EngineeringbyRacingMotorsport/ES_RearECU_HW/ES_RearECU_HW.kicad_pcb

## KiCad design ES_RearECU_HW.kicad_pcb (2026-10-03)

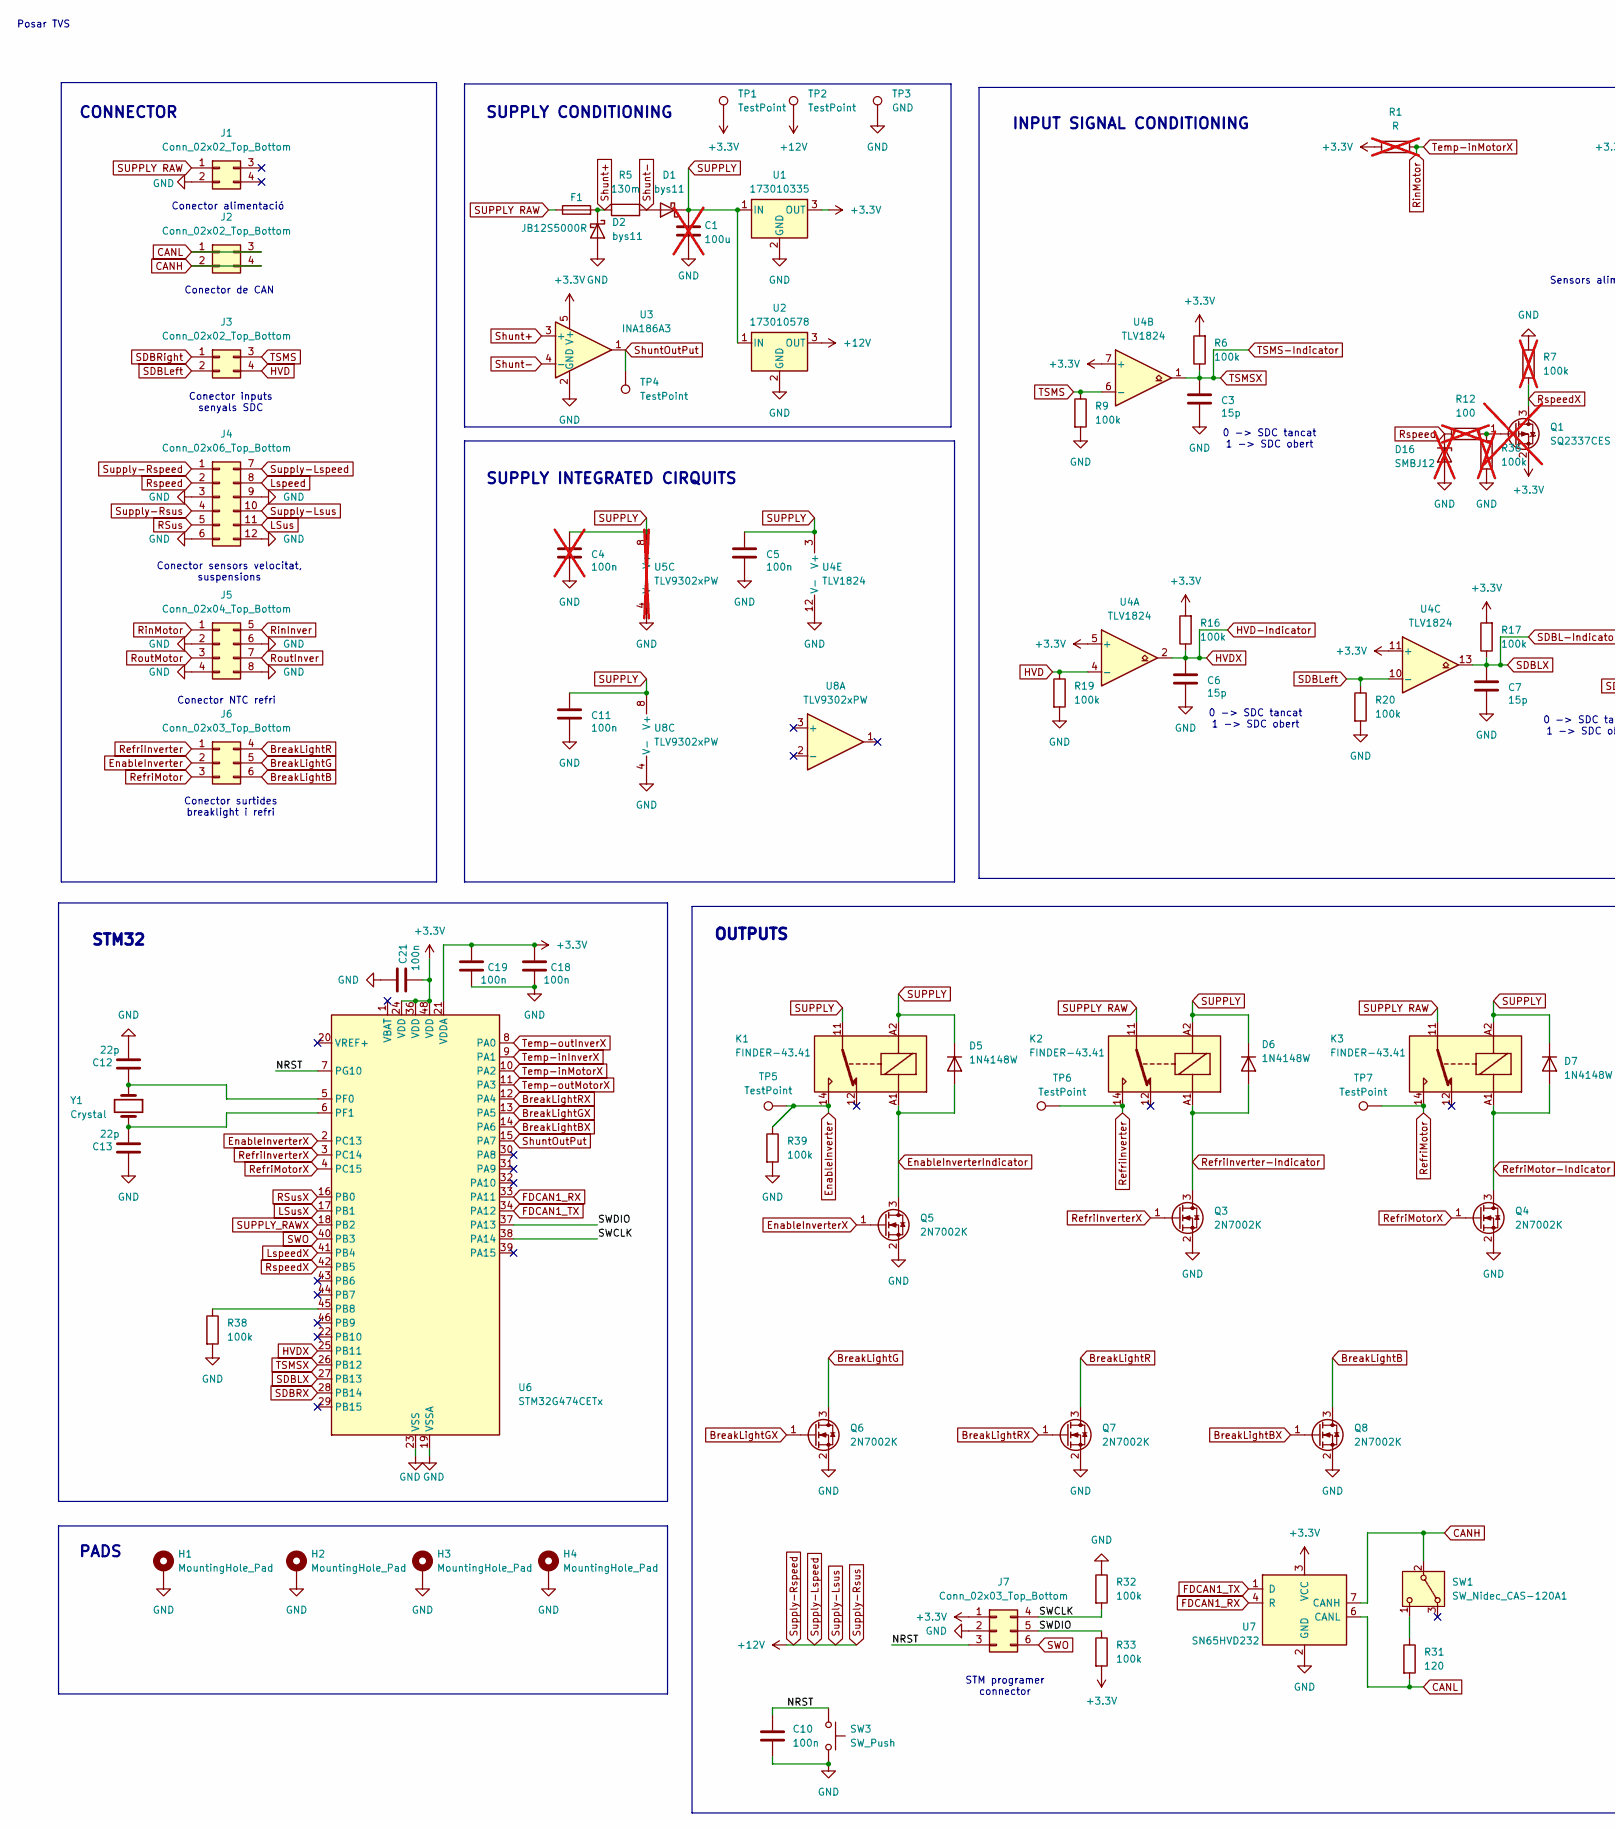
[picture p1: schematic ES_RearECU_HW.kicad_sch, RearEcu_EM-06_1.0, part in row 1, column 1]

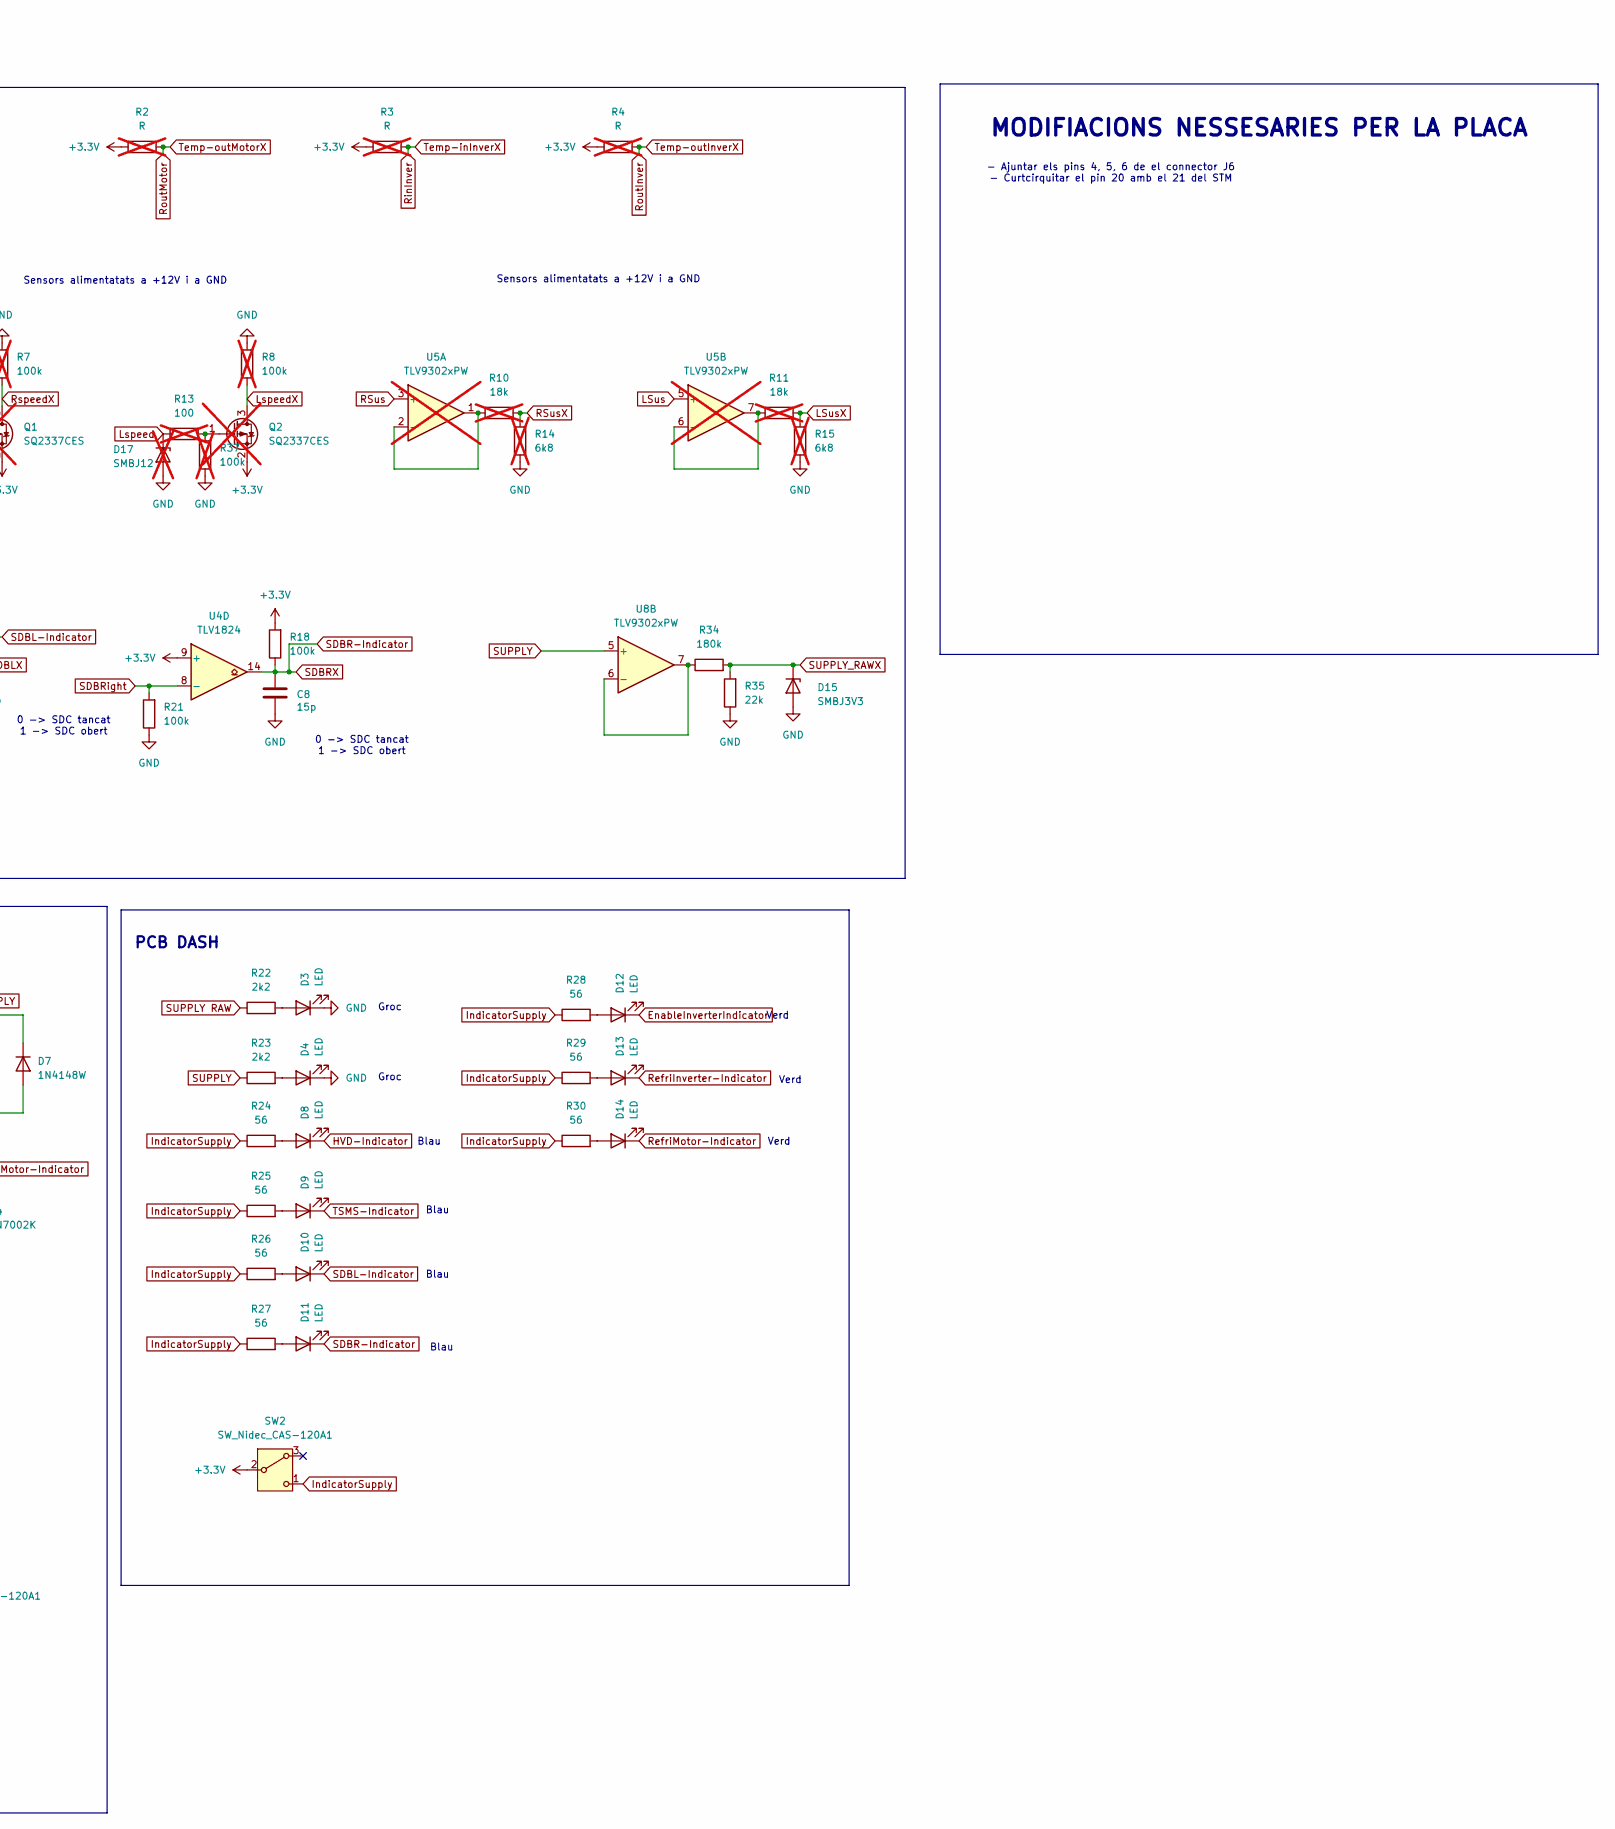
[picture p2: schematic ES_RearECU_HW.kicad_sch, RearEcu_EM-06_1.0, part in row 1, column 2]

Parts:
C1: 100u; CP_Elec_10x10; not fitted
C3, C6, C7, C8: 15p; C_1206_3216Metric
C4: 100n; C_1206_3216Metric; not fitted
C5, C10, C11, C18, C19, C21: 100n; C_1206_3216Metric
C12, C13: 22p; C_1206_3216Metric
D1, D2: bys11; D_SMA
D3, D4, D8, D9, D10, D11, D12, D13, D14: LED; LED_0603_1608Metric
D5, D6, D7: 1N4148W; D_SOD-123
D15: SMBJ3V3; D_SMB
D16, D17: SMBJ12; D_SMB; not fitted
F1: JB12S5000R; Fuse_1206_3216Metric
H1, H2, H3, H4: MountingHole_Pad; MountingHole_3.5mm_Pad_Via
J1, J2, J3: Conn_02x02_Top_Bottom; Molex_Nano-Fit_105314-xx04_2x02_P2.50mm_Horizontal
J4: Conn_02x06_Top_Bottom; Molex_Nano-Fit_105314-xx12_2x06_P2.50mm_Horizontal
J5: Conn_02x04_Top_Bottom; Molex_Nano-Fit_105314-xx08_2x04_P2.50mm_Horizontal
J6: Conn_02x03_Top_Bottom; Molex_Nano-Fit_105314-xx06_2x03_P2.50mm_Horizontal
J7: Conn_02x03_Top_Bottom; Molex_Nano-Fit_105310-xx06_2x03_P2.50mm_Vertical
K1, K2, K3: FINDER-43.41; FINDER434170242001
Q1, Q2: SQ2337CES; SOT-23; not fitted
Q3, Q4, Q5, Q6, Q7, Q8: 2N7002K; SOT-23
R1, R2, R3, R4: R; R_1206_3216Metric; not fitted
R5: 130m; R_1206_3216Metric
R6, R9, R16, R17, R18, R19, R20, R21, R32, R33, R38, R39: 100k; R_1206_3216Metric
R7, R8, R36, R37: 100k; R_1206_3216Metric; not fitted
R10, R11: 18k; R_1206_3216Metric; not fitted
R12, R13: 100; R_1206_3216Metric; not fitted
R14, R15: 6k8; R_1206_3216Metric; not fitted
R22, R23: 2k2; R_1206_3216Metric
R24, R25, R26, R27, R28, R29, R30: 56; R_1206_3216Metric
R31: 120; R_1206_3216Metric
R34: 180k; R_1206_3216Metric
R35: 22k; R_1206_3216Metric
SW1, SW2: SW_Nidec_CAS-120A1; Nidec_Copal_CAS-120A
SW3: SW_Push; SW_Tactile_Straight_KSA0Axx1LFTR
TP1, TP2, TP4, TP5, TP6, TP7: TestPoint; TestPoint_Pad_D1.0mm
TP3: GND; TestPoint_Pad_D1.0mm
U1: 173010335; Converter_DCDC_RECOM_R-78E-0.5_THT
U2: 173010578; Converter_DCDC_RECOM_R-78E-0.5_THT
U3: INA186A3; SOT-23-5
U4: TLV1824; TSSOP-14_4.4x5mm_P0.65mm
U5: TLV9302xPW; TSSOP-8_4.4x3mm_P0.65mm; not fitted
U6: STM32G474CETx; LQFP-48_7x7mm_P0.5mm
U7: SN65HVD232; SOIC-8_3.9x4.9mm_P1.27mm
U8: TLV9302xPW; TSSOP-8_4.4x3mm_P0.65mm
Y1: Crystal; Crystal_SMD_HC49-SD

Connections:
+3.3V: C18.1, C19.1, C21.2, J7.1, Q1.2 (S), Q2.2 (S), R1.1, R2.1, R3.1, R4.1, R6.2, R16.2, R17.2, R18.2, R33.2, SW2.2 (B), TP1.1, U1.3 (OUT), U3.5 (V+), U4.5 (+), U4.7 (+), U4.9 (+), U4.11 (+), U6.21 (VDDA), U6.24 (VDD), U6.36 (VDD), U6.48 (VDD), U7.3 (VCC)
/NRST: C10.1, J7.3, SW3.1, U6.7 (PG10)
/SWCLK: J7.4, R32.2, U6.38 (PA14)
/SWDIO: J7.5, R33.1, U6.37 (PA13)
BreakLightB: J6.6, Q8.3 (D)
BreakLightBX: Q8.1 (G), U6.14 (PA6)
BreakLightG: J6.5, Q6.3 (D)
BreakLightGX: Q6.1 (G), U6.13 (PA5)
BreakLightR: J6.4, Q7.3 (D)
BreakLightRX: Q7.1 (G), U6.12 (PA4)
CANH: J2.2, J2.4, SW1.2 (B), U7.7 (CANH)
CANL: J2.1, J2.3, R31.2, U7.6 (CANL)
EnableInverter: J6.2, K1.14, R39.1, TP5.1
EnableInverterIndicator: D5.2 (A), D12.1 (K), K1.A1, Q5.3 (D)
EnableInverterX: Q5.1 (G), U6.2 (PC13)
FDCAN1_RX: U6.33 (PA11), U7.4 (R)
FDCAN1_TX: U6.34 (PA12), U7.1 (D)
GND: C1.2, C3.2, C4.2, C5.2, C6.2, C7.2, C8.2, C10.2, C11.2, C12.2, C13.1, C18.2, C19.2, C21.1, D2.2 (A), D3.1 (K), D4.1 (K), D15.2 (A), D16.2 (A), D17.2 (A), H1.1, H2.1, H3.1, H4.1, J1.2, J4.3, J4.6, J4.9, J4.12, J5.2, J5.4, J5.6, J5.8, J7.2, Q3.2 (S), Q4.2 (S), Q5.2 (S), Q6.2 (S), Q7.2 (S), Q8.2 (S), R7.1, R8.1, R9.2, R14.1, R15.1, R19.2, R20.2, R21.1, R32.1, R35.1, R36.2, R37.2, R38.2, R39.2, SW3.2, TP3.1, U1.2 (GND), U2.2 (GND), U3.2 (GND), U4.12 (V-), U5.4 (V-), U6.19 (VSSA), U6.23 (VSS), U6.35 (VSS), U6.47 (VSS), U7.2 (GND), U8.4 (V-)
HVD: J3.4, R19.1, U4.4 (-)
HVD-Indicator: C6.1, D8.1 (K), R16.1, U4.2, U6.25 (PB11)
IndicatorSupply: R24.1, R25.1, R26.1, R27.1, R28.1, R29.1, R30.1, SW2.1 (C)
LSus: J4.11, U5.5 (+)
LSusX: R11.2, R15.2, U6.17 (PB1)
Lspeed: D17.1 (K), J4.8, R13.1
LspeedX: Q2.3 (D), R8.2, U6.41 (PB4)
unnamed: D3.2 (A), R22.2
unnamed: D4.2 (A), R23.2
unnamed: D8.2 (A), R24.2
unnamed: D9.2 (A), R25.2
unnamed: D10.2 (A), R26.2
unnamed: D11.2 (A), R27.2
unnamed: D12.2 (A), R28.2
unnamed: D13.2 (A), R29.2
unnamed: D14.2 (A), R30.2
unnamed: Q1.1 (G), R12.2, R36.1
unnamed: Q2.1 (G), R13.2, R37.1
unnamed: R31.1, SW1.1 (C)
unnamed: R10.1, U5.1, U5.2 (-)
unnamed: R11.1, U5.6 (-), U5.7
unnamed: R38.1, U6.45 (PB8)
unnamed: C12.1, U6.5 (PF0), Y1.1
unnamed: C13.2, U6.6 (PF1), Y1.2
unnamed: R34.1, U8.6 (-), U8.7
RSus: J4.5, U5.3 (+)
RSusX: R10.2, R14.2, U6.16 (PB0)
RefriInverter: J6.1, K2.14, TP6.1
RefriInverter-Indicator: D6.2 (A), D13.1 (K), K2.A1, Q3.3 (D)
RefriInverterX: Q3.1 (G), U6.3 (PC14)
RefriMotor: J6.3, K3.14, TP7.1
RefriMotor-Indicator: D7.2 (A), D14.1 (K), K3.A1, Q4.3 (D)
RefriMotorX: Q4.1 (G), U6.4 (PC15)
RinInver: J5.5, R3.2, U6.9 (PA1)
RinMotor: J5.1, R1.2, U6.10 (PA2)
RoutInver: J5.7, R4.2, U6.8 (PA0)
RoutMotor: J5.3, R2.2, U6.11 (PA3)
Rspeed: D16.1 (K), J4.2, R12.1
RspeedX: Q1.3 (D), R7.2, U6.42 (PB5)
SDBL-Indicator: C7.1, D10.1 (K), R17.1, U4.13, U6.27 (PB13)
SDBLeft: J3.2, R20.1, U4.10 (-)
SDBR-Indicator: C8.1, D11.1 (K), R18.1, U4.14, U6.28 (PB14)
SDBRight: J3.1, R21.2, U4.8 (-)
SUPPLY: C1.1, C4.1, C5.1, C11.1, D1.1 (K), D5.1 (K), D6.1 (K), D7.1 (K), K1.11, K1.A2, K2.A2, K3.A2, R23.1, U1.1 (IN), U2.1 (IN), U4.3 (V+), U5.8 (V+), U8.5 (+), U8.8 (V+)
SUPPLY RAW: F1.1, J1.1, K2.11, K3.11, R22.1
SUPPLY_RAWX: D15.1 (K), R34.2, R35.2, U6.18 (PB2)
SWO: J7.6, U6.40 (PB3)
Shunt+: D2.1 (K), F1.2, R5.1, U3.3 (+)
Shunt-: D1.2 (A), R5.2, U3.4 (-)
ShuntOutPut: TP4.1, U3.1, U6.15 (PA7)
Supply-Lspeed: J4.1, J4.4, J4.7, J4.10, TP2.1, U2.3 (OUT)
TSMS: J3.3, R9.1, U4.6 (-)
TSMS-Indicator: C3.1, D9.1 (K), R6.1, U4.1, U6.26 (PB12)

Notes on the sheet:
STM programer connector
- Ajuntar els pins 4, 5, 6 de el connector J6 - Curtcirquitar el pin 20 amb el 21 del STM
Posar TVS
Conector NTC refri
Blau
0 -> SDC tancat 1 -> SDC obert
Groc
Blau
SUPPLY INTEGRATED CIRQUITS
Conector de CAN
MODIFIACIONS NESSESARIES PER LA PLACA
0 -> SDC tancat 1 -> SDC obert
SUPPLY CONDITIONING
Conector inputs senyals SDC
INPUT SIGNAL CONDITIONING
Sensors alimentatats a +12V i a GND
Conector surtides breaklight i refri
STM32
PCB DASH
Verd
CONNECTOR
OUTPUTS
PADS
Conector sensors velocitat, suspensions
Conector alimentació

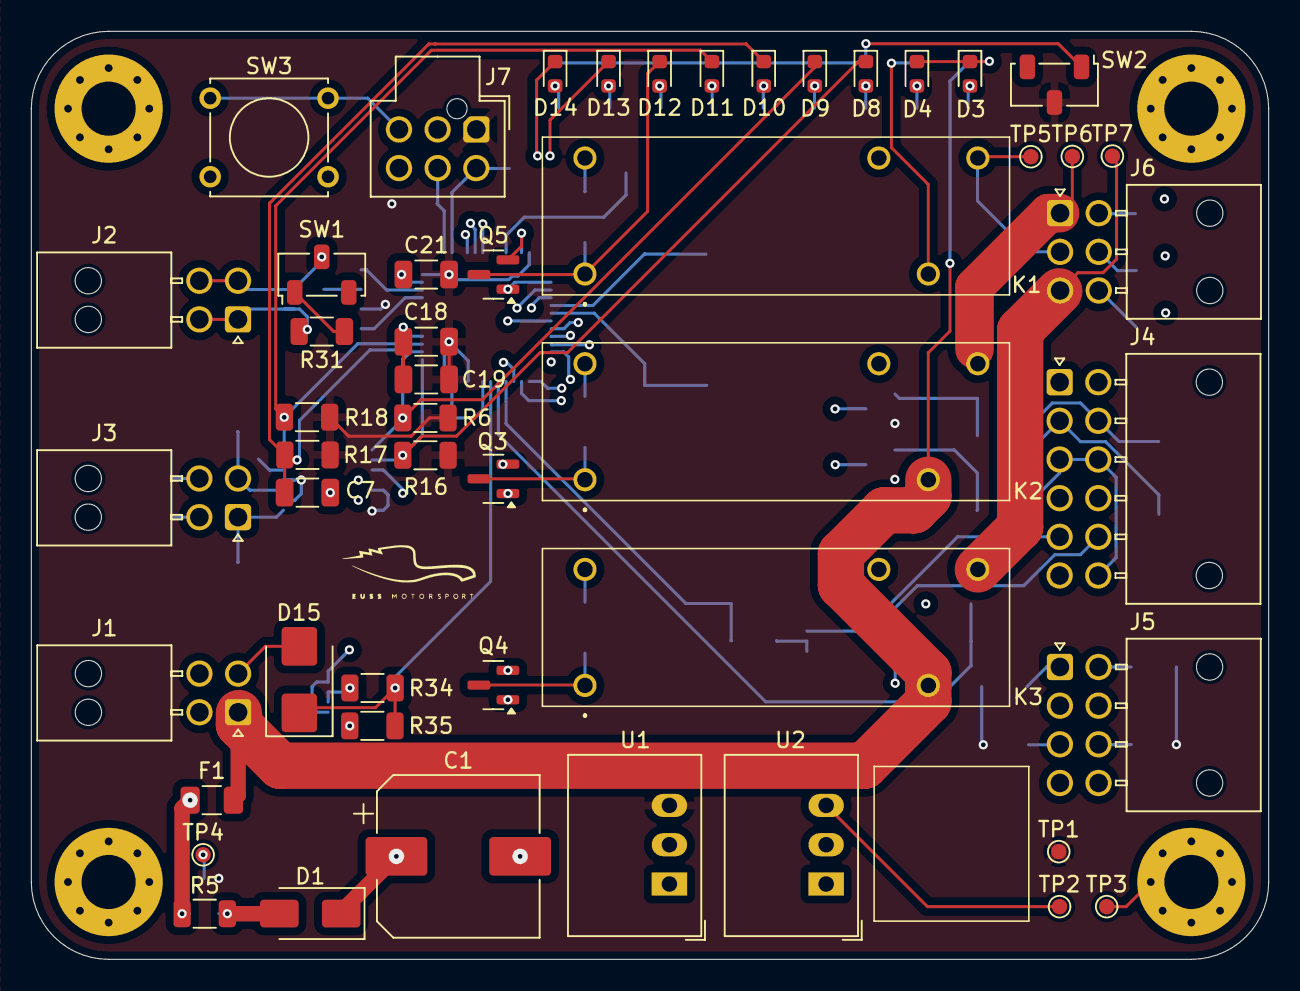
[picture p3: board ES_RearECU_HW.kicad_pcb from above]

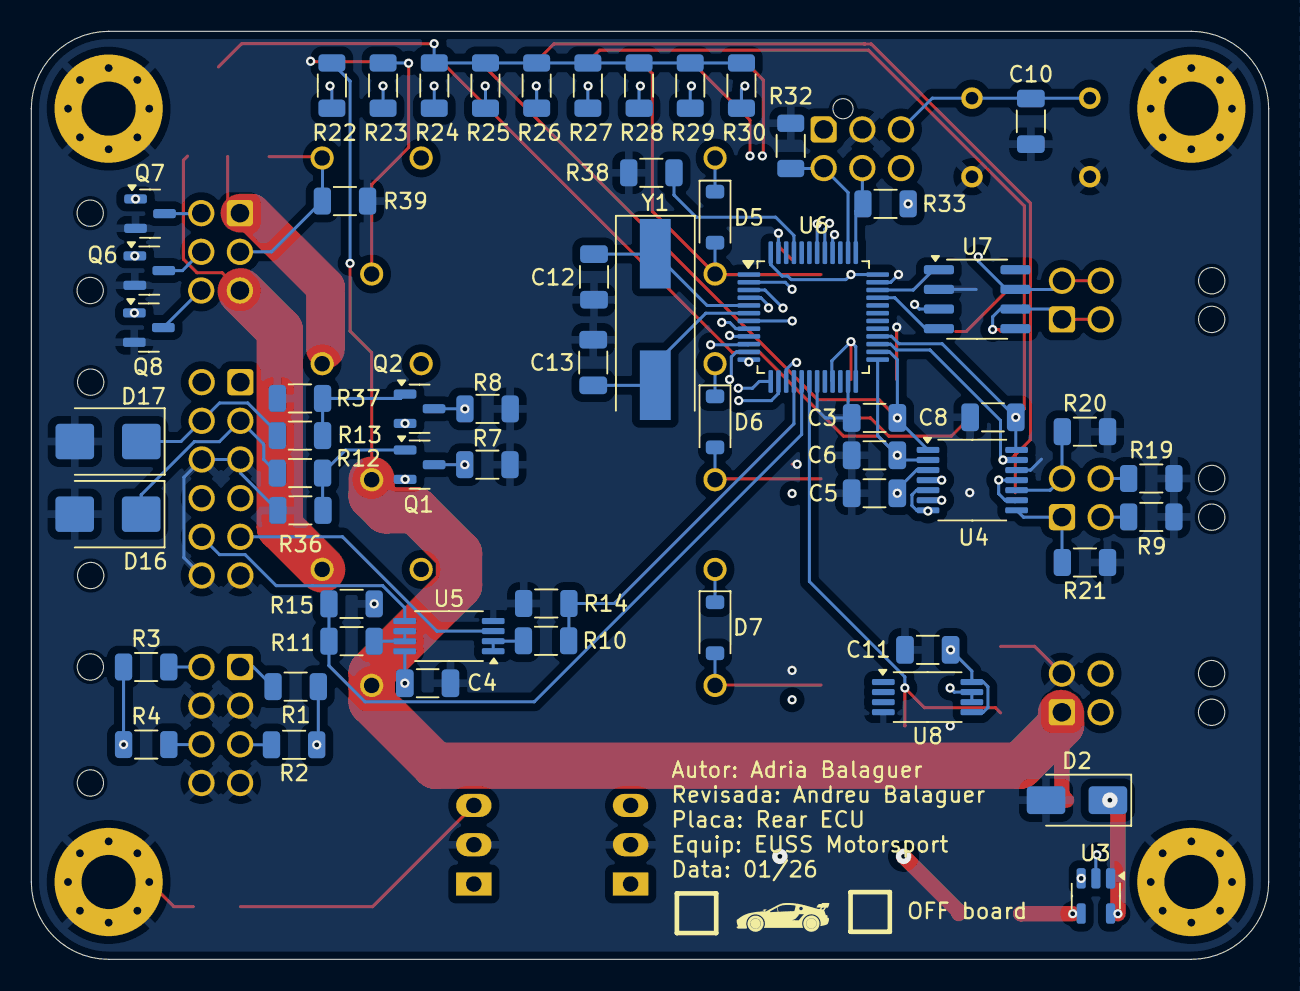
[picture p4: board ES_RearECU_HW.kicad_pcb from below]

Board: 4 copper layers, 80.0 x 60.0 mm, 112 parts (58 on the bottom side), 71 nets.
